cajui/cajui-hardware/enclosures/heltec-wifi-lora-32-v3/receiver/print/lid.stl

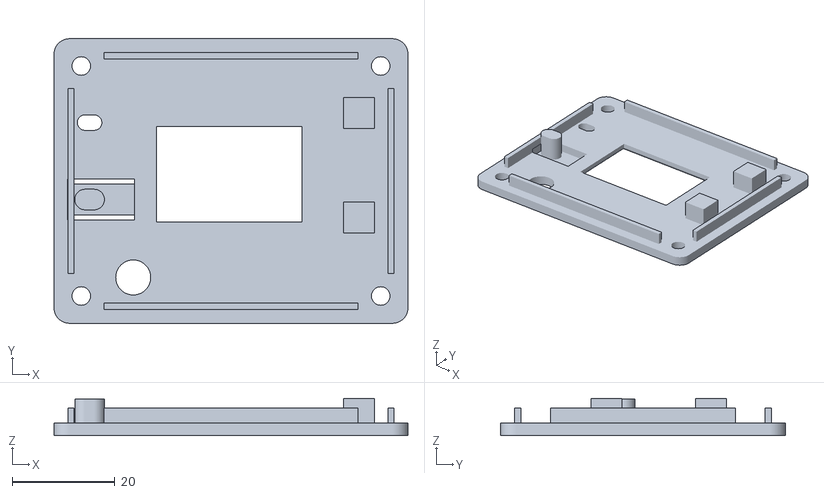
[picture p3: CAD file, 2026-11-12]
enclosures/heltec-wifi-lora-32-v3/receiver/print/lid.stl
68.8 x 55.3 x 7.20
