cajui/cajui-hardware/enclosures/heltec-wireless-stick-lite-v3/transmitter/print/board-carrier.stl

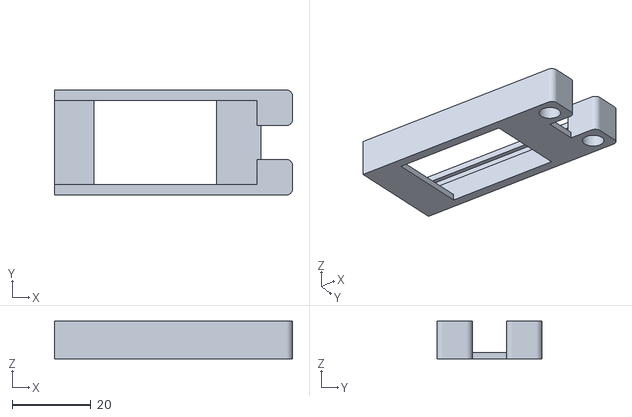
[picture p4: CAD file, 2026-11-09]
enclosures/heltec-wireless-stick-lite-v3/transmitter/print/board-carrier.stl
60.3 x 26.6 x 9.50
