cajui/cajui-hardware/enclosures/heltec-wifi-lora-32-v3/receiver/print/body.stl

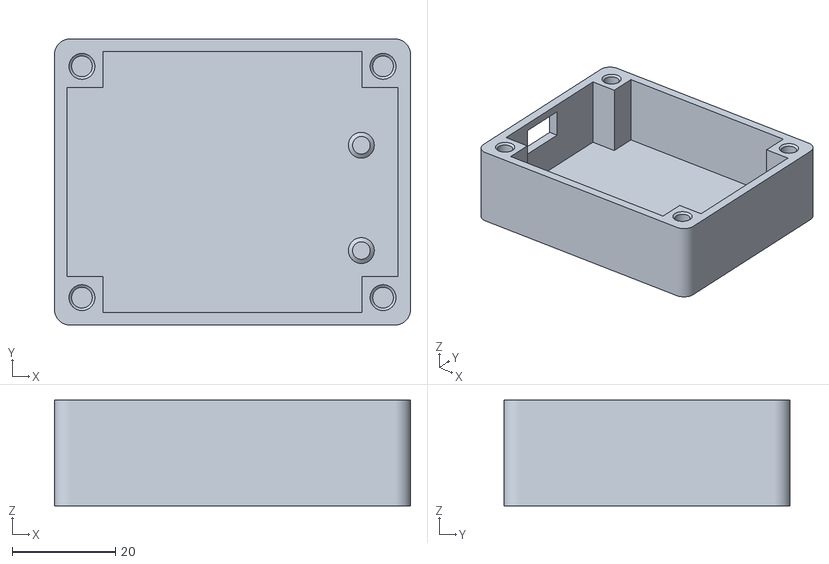
[picture p5: CAD file, 2026-11-12]
enclosures/heltec-wifi-lora-32-v3/receiver/print/body.stl
68.8 x 55.3 x 20.4
