cajui/cajui-hardware/enclosures/heltec-wireless-stick-lite-v3/transmitter/print/lid.stl

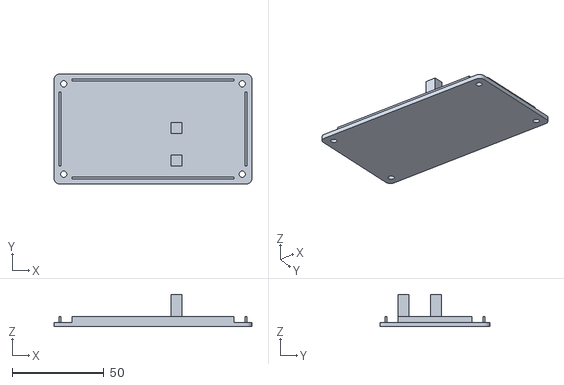
[picture p6: CAD file, 2026-11-09]
enclosures/heltec-wireless-stick-lite-v3/transmitter/print/lid.stl
107.8 x 59.8 x 17.6
