cajui/cajui-hardware/enclosures/heltec-wifi-lora-32-v3/receiver/print/board-carrier.stl

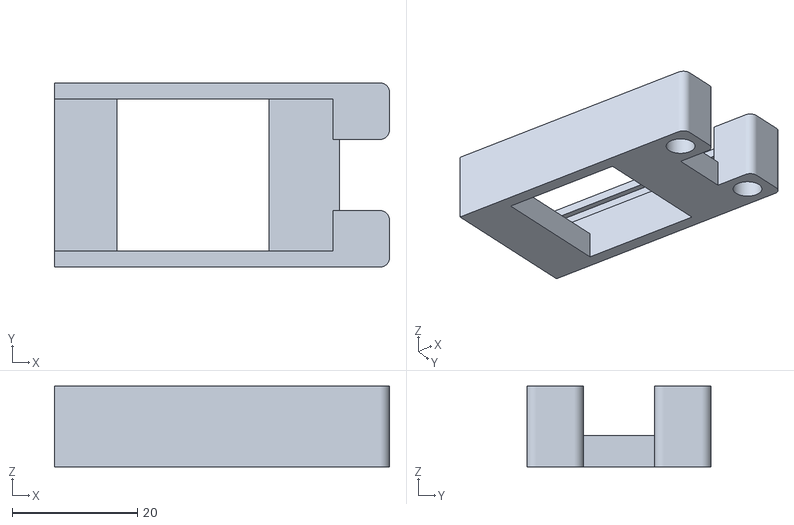
[picture p7: CAD file, 2026-11-12]
enclosures/heltec-wifi-lora-32-v3/receiver/print/board-carrier.stl
53.4 x 29.4 x 12.9
