cajui/cajui-hardware/enclosures/heltec-wireless-stick-lite-v3/transmitter/print/body.stl

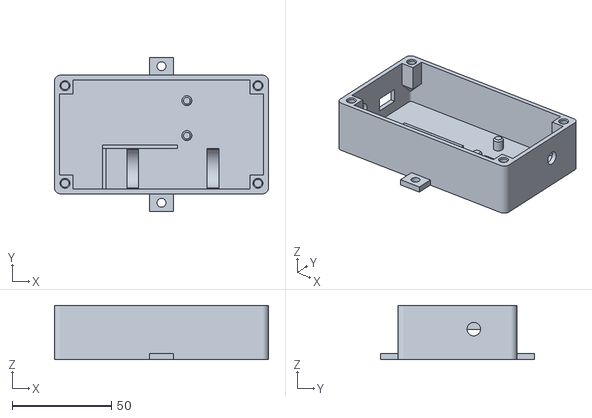
[picture p8: CAD file, 2026-11-09]
enclosures/heltec-wireless-stick-lite-v3/transmitter/print/body.stl
107.8 x 77.8 x 27.4
