cajui/cajui-hardware/enclosures/heltec-wireless-stick-lite-v3/transmitter/print/usb-cover.stl

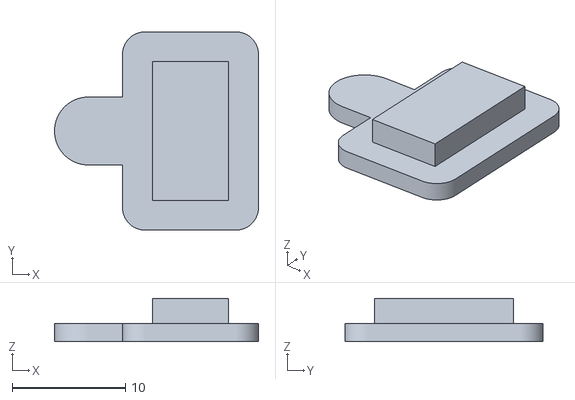
[picture p9: CAD file, 2026-11-09]
enclosures/heltec-wireless-stick-lite-v3/transmitter/print/usb-cover.stl
18.0 x 17.5 x 3.80
