cajui/cajui-hardware/(commit log)

2026-11-09 feat(wide): add the wide enclosure for the Wireless Stick Lite V3 at r05
    Start the hardware repository with the only enclosure in use, so printers get the
    current STLs and the parametric source together. Earlier revisions are left out
    because they are no longer printed.
    Claude-Session: https://claude.ai/code/session_01G4fhgQsnhJnQiMx2ZpeXik
    [board-carrier.stl, body.stl, lid.stl, usb-cover.stl]
2026-11-09 refactor: organise enclosures by board and function
    "Wide" said nothing about which board an enclosure fits. Folders now follow the
    cajui-firmware board profiles, then the function, so each future board and the
    receiver have an obvious place. Revisions are numbered per enclosure and tagged
    <board>/<function>/rNN. Geometry is unchanged: every STL keeps its SHA-256.
    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
    [board-carrier.stl, body.stl, lid.stl, usb-cover.stl]
2026-11-11 feat(wifi-lora-32-v3): add the receiver enclosure at r01
    First layout of a shelf box for the WiFi LoRa 32 V3 receiver: the board lies flat on a
    carrier with rails, the OLED shows through a chamfered window in the lid, PRG is pressed
    through a flexible tab and RST through a pinhole, the USB-C leaves through the back wall
    and the bulkhead SMA stands on the lid at the back corner. Untested; the limits list the
    estimated values and the board length uncertainty the lid openings are stretched for.
    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
    [board-carrier.stl, body.stl, lid.stl]
2026-11-12 feat(wifi-lora-32-v3): close the receiver window in on the display at r02
    The r01 dry fit of the carrier and the lid showed glass without display at the
    antenna end, on the RST side and a little at the USB end. The lid window now sits
    inside the glass outline by 1 mm at the USB end, 4 mm at the antenna end and
    1.78 mm on the RST side, sized by eye on that fit; the dark display area was not
    measured. Lid only: body and carrier keep their r01 hashes.
    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
    [lid.stl]
2026-11-12 docs(wifi-lora-32-v3): record the r02 lid dry fit of the receiver
    The r02 lid was printed and dry-fitted with the board: the window was
    reported good over the display. The body is still untested.
    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
2026-11-12 docs(wifi-lora-32-v3): record the receiver assembled and working at r02
    Body, carrier and lid were printed and assembled with the board; the
    enclosure was reported working. The window pane is still undecided.
    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
2026-11-12 docs(wifi-lora-32-v3): say which side the receiver enclosure is read from
    The setup screen is rotated in the firmware for this enclosure, so the
    README states the reading side and what that does to a bare board.
    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
